WAFFLE-Systems/PEC_Sensor/PEC_Sensor.kicad_pcb

## KiCad design PEC_Sensor.kicad_pcb (2026-03-24)

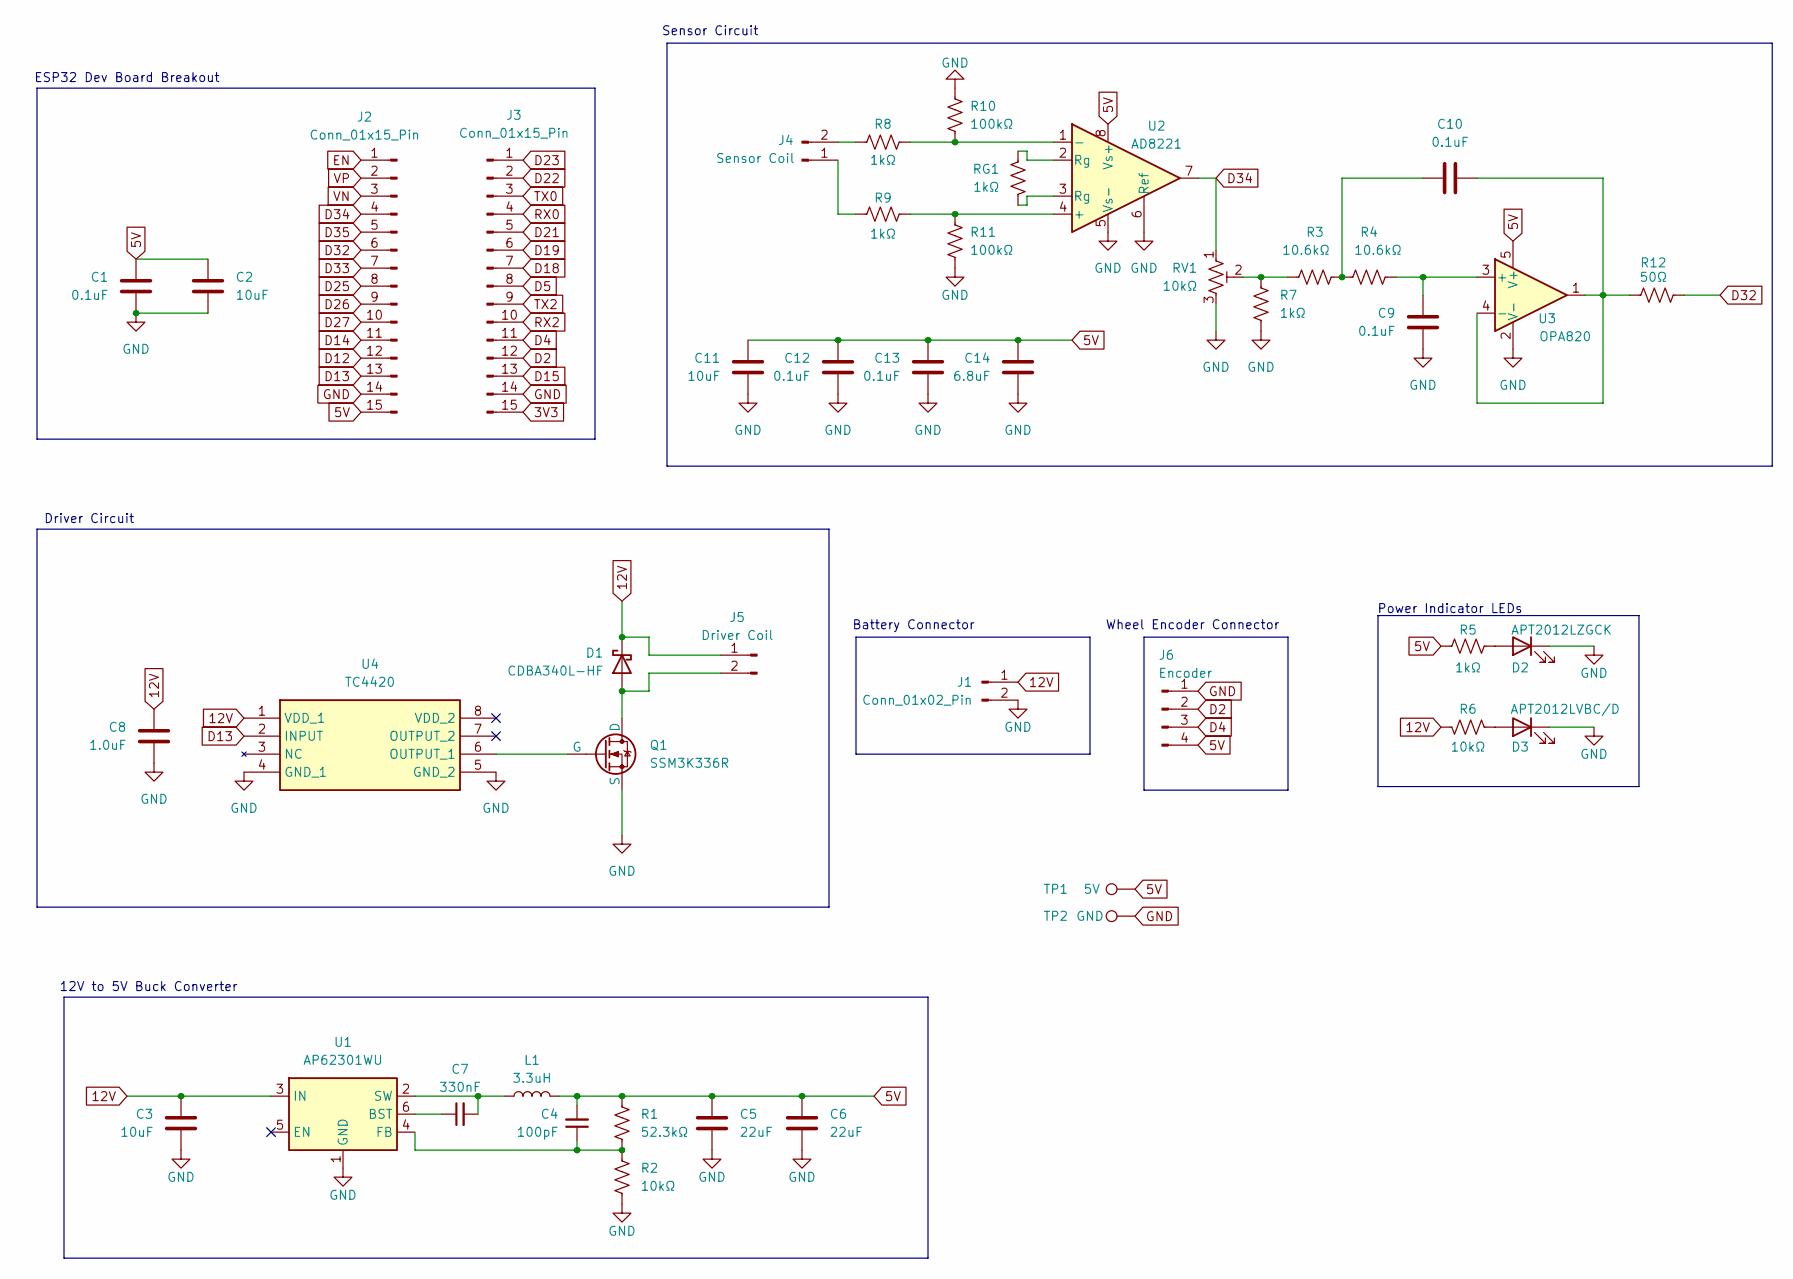
[picture p1: schematic PEC_Sensor.kicad_sch, NDT Scanner Device]

Parts:
C1, C9, C10, C12, C13: 0.1uF; C_0603_1608Metric_Pad1.08x0.95mm_HandSolder
C2, C11: 10uF; C_0603_1608Metric_Pad1.08x0.95mm_HandSolder
C3: 10uF; C_0805_2012Metric_Pad1.18x1.45mm_HandSolder
C4: 100pF; C_0603_1608Metric_Pad1.08x0.95mm_HandSolder
C5, C6: 22uF; C_0805_2012Metric_Pad1.18x1.45mm_HandSolder
C7: 330nF; C_0603_1608Metric_Pad1.08x0.95mm_HandSolder
C8: 1.0uF; C_0603_1608Metric_Pad1.08x0.95mm_HandSolder
C14: 6.8uF; C_0603_1608Metric_Pad1.08x0.95mm_HandSolder
D1: CDBA340L-HF; D_SMA_Handsoldering
D2: APT2012LZGCK; LED_0805_2012Metric_Pad1.15x1.40mm_HandSolder
D3: APT2012LVBC/D; LED_0805_2012Metric_Pad1.15x1.40mm_HandSolder
J1: Conn_01x02_Pin; BarrelJack_Horizontal
J2, J3: Conn_01x15_Pin; PinHeader_1x15_P2.54mm_Vertical
J4: Sensor Coil; JST_EH_S2B-EH_1x02_P2.50mm_Horizontal
J5: Driver Coil; JST_EH_S2B-EH_1x02_P2.50mm_Horizontal
J6: Encoder; JST_EH_S4B-EH_1x04_P2.50mm_Horizontal
L1: 3.3uH; L_Taiyo-Yuden_NR-40xx
Q1: SSM3K336R; TSOT-23
R1: 52.3kΩ; R_0603_1608Metric_Pad0.98x0.95mm_HandSolder
R2, R6: 10kΩ; R_0603_1608Metric_Pad0.98x0.95mm_HandSolder
R3, R4: 10.6kΩ; R_0603_1608Metric_Pad0.98x0.95mm_HandSolder
R5, R7, R8, R9: 1kΩ; R_0603_1608Metric_Pad0.98x0.95mm_HandSolder
R10, R11: 100kΩ; R_0603_1608Metric_Pad0.98x0.95mm_HandSolder
R12: 50Ω; R_0603_1608Metric_Pad0.98x0.95mm_HandSolder
RG1: 1kΩ; R_0603_1608Metric_Pad0.98x0.95mm_HandSolder
RV1: 10kΩ; Potentiometer_Bourns_TC33X_Vertical
TP1: 5V; TestPoint_THTPad_D2.0mm_Drill1.0mm
TP2: GND; TestPoint_THTPad_D2.0mm_Drill1.0mm
U1: AP62301WU; TSOT-23-6
U2: AD8221; SOIC-8_3.9x4.9mm_P1.27mm
U3: OPA820; SOT-23-5
U4: TC4420; SOIC-8_3.9x4.9mm_P1.27mm; Mouser Part Number 579-TC4429EOA

Connections:
3V3: J3.15
5V: C1.1, C2.1, C4.2, C5.1, C6.1, C11.2, C12.2, C13.2, C14.2, J2.15, J6.4, L1.2, R1.1, R5.1, TP1.1, U2.8 (Vs+), U3.5 (V+)
12V: C3.1, C8.1, D1.1 (K), J1.1, J5.1, R6.1, U1.3 (IN), U4.1 (VDD_1)
D2: J3.12, J6.2
D4: J3.11, J6.3
D5: J3.8
D12: J2.12
D13: J2.13, U4.2 (INPUT)
D14: J2.11
D15: J3.13
D18: J3.7
D19: J3.6
D21: J3.5
D22: J3.2
D23: J3.1
D25: J2.8
D26: J2.9
D27: J2.10
D32: J2.6, R12.1
D33: J2.7
D34: J2.4, RV1.1, U2.7
D35: J2.5
EN: J2.1
GND: C1.2, C2.2, C3.2, C5.2, C6.2, C8.2, C9.2, C11.1, C12.1, C13.1, C14.1, D2.1 (K), D3.1 (K), J1.2, J2.14, J3.14, J6.1, Q1.2 (S), R2.2, R7.2, R10.2, R11.1, RV1.3, TP2.1, U1.1 (GND), U2.5 (Vs-), U2.6 (Ref), U3.2 (V-), U4.4 (GND_1), U4.5 (GND_2)
unnamed: C10.1, R3.1, R4.2
unnamed: D1.2 (A), J5.2, Q1.3 (D)
unnamed: D2.2 (A), R5.2
unnamed: D3.2 (A), R6.2
unnamed: J4.1, R9.1
unnamed: J4.2, R8.1
unnamed: Q1.1 (G), U4.6 (OUTPUT_1)
unnamed: R3.2, R7.1, RV1.2
unnamed: RG1.1, U2.3 (Rg)
unnamed: RG1.2, U2.2 (Rg)
unnamed: C7.1, U1.6 (BST)
unnamed: C4.1, R1.2, R2.1, U1.4 (FB)
unnamed: C7.2, L1.1, U1.2 (SW)
unnamed: R9.2, R11.2, U2.4 (+)
unnamed: R8.2, R10.1, U2.1 (-)
unnamed: C9.1, R4.1, U3.3 (+)
unnamed: C10.2, R12.2, U3.1, U3.4 (-)
RX0: J3.4
RX2: J3.10
TX0: J3.3
TX2: J3.9
VN: J2.3
VP: J2.2

Notes on the sheet:
Driver Circuit
Sensor Circuit
Wheel Encoder Connector
12V to 5V Buck Converter
Power Indicator LEDs
ESP32 Dev Board Breakout
Battery Connector

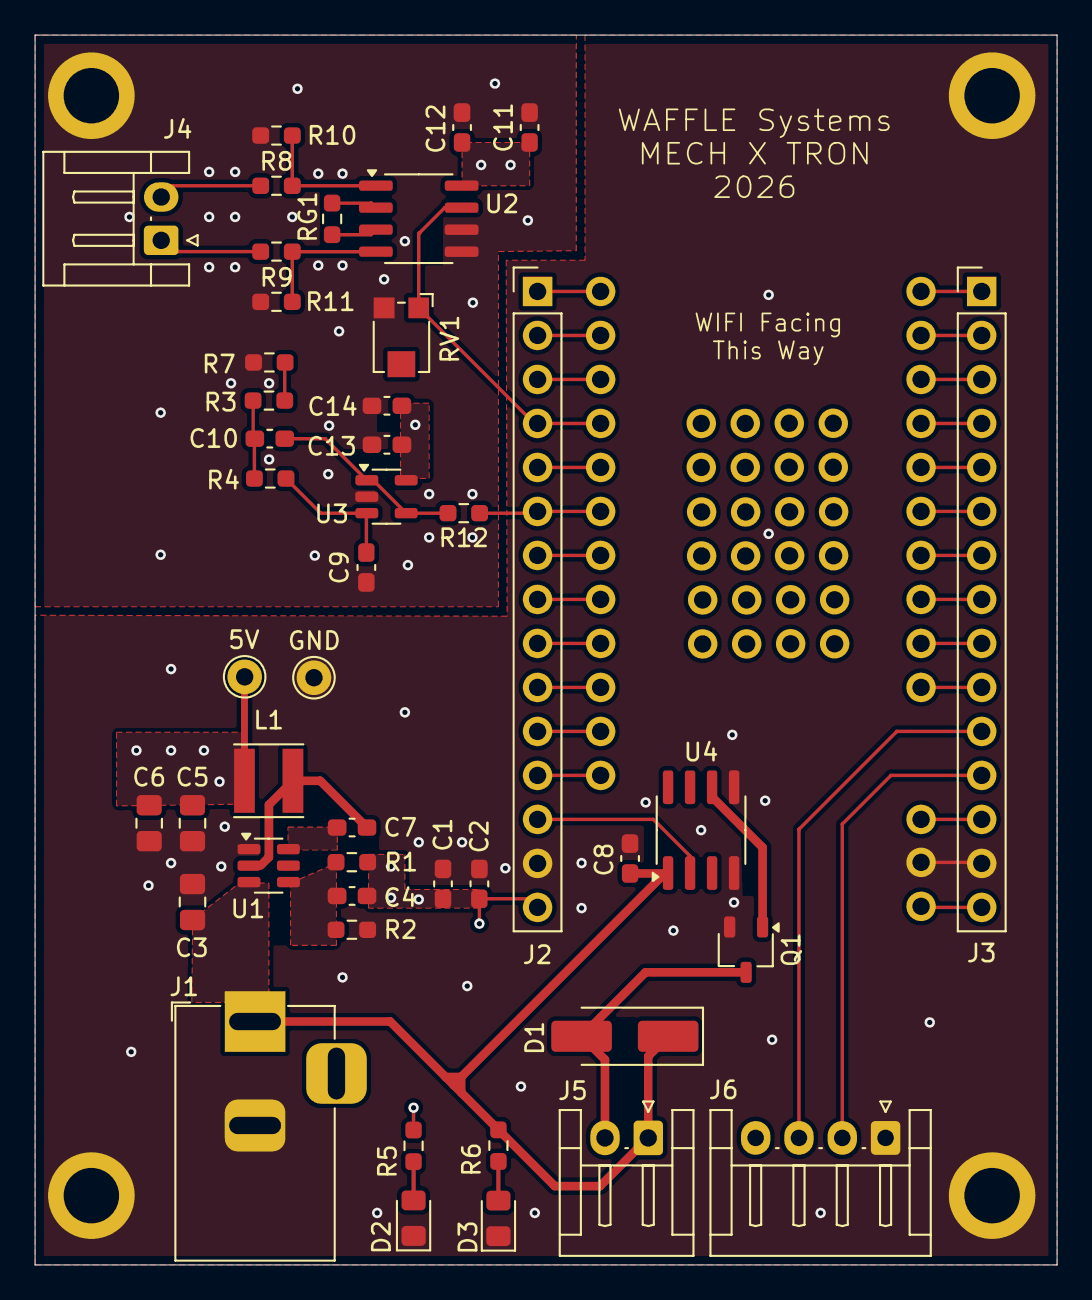
[picture p2: board PEC_Sensor.kicad_pcb from above]

Board: 4 copper layers, 59.0 x 71.0 mm, 45 parts (0 on the bottom side), 25 nets.
