WAFFLE-Systems/PEC_Sensor/(commit log)

2026-01-14 revised circuits
    [PEC_Sensor.kicad_sch]
2026-01-15 revision 2 finished
    [PEC_Sensor.kicad_pcb, PEC_Sensor.kicad_sch]
2026-01-19 fixed gitignore
    [PEC_Sensor.kicad_pcb, PEC_Sensor.kicad_sch]
2026-01-29 jan 29
    [C14D32P-C3.step, PEC_Sensor.kicad_pcb, PEC_Sensor.kicad_sch]
2026-02-03 finished footprints
    [PEC_Sensor.kicad_pcb, PEC_Sensor.kicad_sch]
2026-02-16 final design done
    [PEC_Sensor.kicad_pcb, PEC_Sensor.kicad_sch]
2026-03-04 updated led values
    [PEC_Sensor.kicad_pcb, PEC_Sensor.kicad_sch]
2026-03-09 updated resistor values
    [PEC_Sensor.kicad_sch]
2026-03-10 updated BOM
    [PEC_Sensor_BOM.csv]
2026-03-24 improved design post symposium
    [PEC_Sensor.kicad_pcb, PEC_Sensor.kicad_sch]
